vitormosousa/Wireless-anemometer/hardware_esp8266-anemometer/noname.kicad_pcb

## KiCad design hardware_esp8266-anemometer/noname.kicad_pcb (2019-09-09)

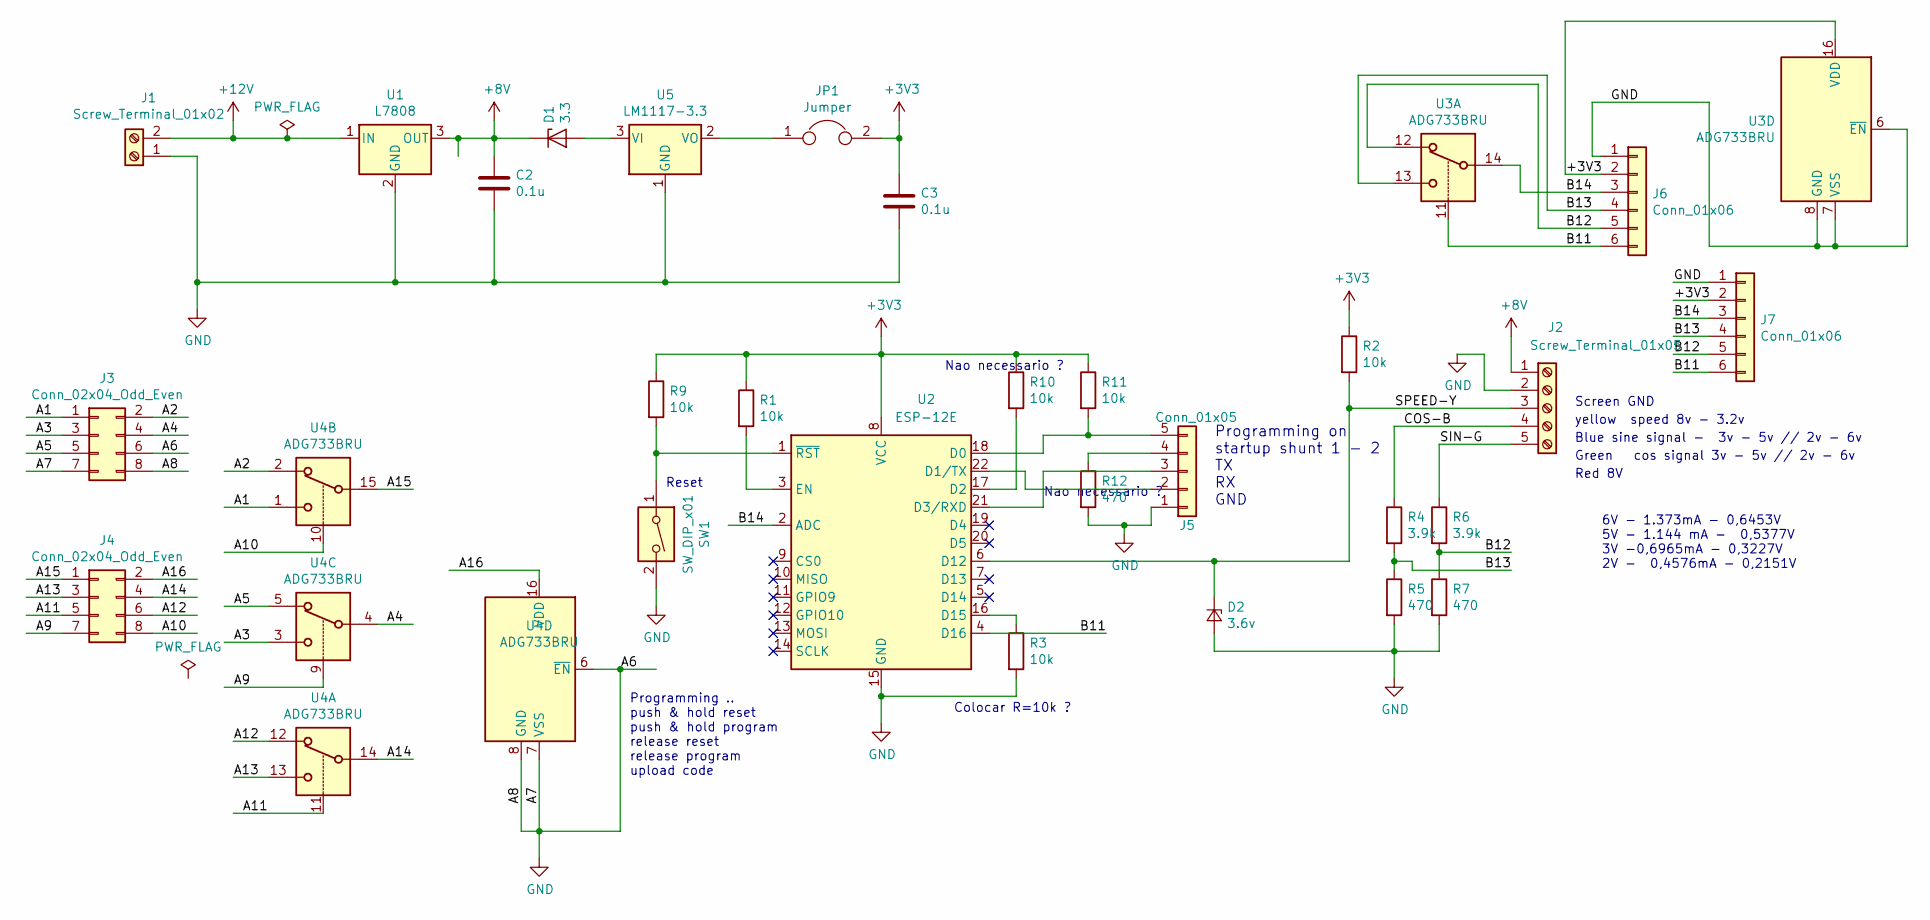
[picture p1: schematic esp8266-anemometer.sch]

Parts:
C2, C3: 0.1u; C_Disc_D4.3mm_W1.9mm_P5.00mm
D1: 3.3; D_DO-15_P10.16mm_Horizontal
D2: 3.6v; D_DO-15_P5.08mm_Vertical_AnodeUp
J1: Screw_Terminal_01x02; TerminalBlock_bornier-2_P5.08mm
J2: Screw_Terminal_01x05; TerminalBlock_bornier-5_P5.08mm
J3, J4: Conn_02x04_Odd_Even; PinHeader_2x04_P2.54mm_Vertical
J5: Conn_01x05; PinHeader_1x05_P2.54mm_Vertical
J6, J7: Conn_01x06; PinHeader_1x06_P2.54mm_Vertical
JP1: Jumper; PinHeader_1x02_P2.54mm_Vertical
R1, R10, R11: 10k; R_Axial_DIN0207_L6.3mm_D2.5mm_P10.16mm_Horizontal
R2, R3: 10k; R_Axial_DIN0204_L3.6mm_D1.6mm_P5.08mm_Vertical
R4, R6: 3.9k; R_Axial_DIN0207_L6.3mm_D2.5mm_P10.16mm_Horizontal
R5, R7, R12: 470; R_Axial_DIN0207_L6.3mm_D2.5mm_P10.16mm_Horizontal
R9: 10k; R_Axial_DIN0207_L6.3mm_D2.5mm_P15.24mm_Horizontal
SW1: SW_DIP_x01; SW_PUSH_6mm
U1: L7808; TO-220-3_Vertical
U2: ESP-12E
U3, U4: ADG733BRU; TSSOP-16_4.4x5mm_P0.65mm
U5: LM1117-3.3; TO-220-3_Vertical

Connections:
+8V: C2.1, D1.1 (K), J2.1, U1.3 (OUT)
+12V: J1.2, U1.1 (IN)
/A1: J3.1, U4.1
/A2: J3.2, U4.2
/A3: J3.3, U4.3
/A4: J3.4, U4.4
/A5: J3.5, U4.5
/A9: J4.7, U4.9
/A10: J4.8, U4.10
/A11: J4.5, U4.11
/A12: J4.6, U4.12
/A13: J4.3, U4.13
/A14: J4.4, U4.14
/A15: J4.1, U4.15
/A16: J4.2, U4.16 (VDD)
/B11: J6.6, J7.6, U2.4 (D16), U3.11
/B12: J6.5, J7.5, R6.2, R7.1, U3.12
/B13: J6.4, J7.4, R4.2, R5.1, U3.13
/B14: J6.3, J7.3, U2.2 (ADC), U3.14
/COS-B: J2.4, R4.1
/SIN-G: J2.5, R6.1
/SPEED-Y: D2.1 (K), J2.3, R2.2, U2.6 (D12)
GND: C2.2, C3.2, D2.2 (A), J1.1, J2.2, J3.6, J3.7, J3.8, J5.1, J6.1, J7.1, R3.2, R5.2, R7.2, R12.2, SW1.2, U1.2 (GND), U2.15 (GND), U3.6 (~EN), U3.7 (VSS), U3.8 (GND), U4.6 (~EN), U4.7 (VSS), U4.8 (GND), U5.1 (GND)
unnamed: D1.2 (A), U5.3 (VI)
unnamed: J5.2, U2.22 (D1/TX)
unnamed: J5.3, U2.21 (D3/RXD)
unnamed: J5.4, R12.1
unnamed: J5.5, R11.2, U2.18 (D0)
unnamed: JP1.1, U5.2 (VO)
unnamed: R1.2, U2.3 (EN)
unnamed: R3.1, U2.16 (D15)
unnamed: R9.2, SW1.1, U2.1 (~RST)
unnamed: R10.2, U2.17 (D2)

Notes on the sheet:
Red 8V
Screen GND
Blue sine signal - 3v - 5v // 2v - 6v
Green cos signal 3v - 5v // 2v - 6v
yellow speed 8v - 3.2v
Programming on startup shunt 1 - 2 TX RX GND
Programming .. push & hold reset push & hold program release reset release program upload code
Reset
Colocar R=10k ?
Nao necessario ?
6V - 1.373mA - 0,6453V 5V - 1.144 mA - 0,5377V 3V -0,6965mA - 0,3227V 2V - 0,4576mA - 0,2151V

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
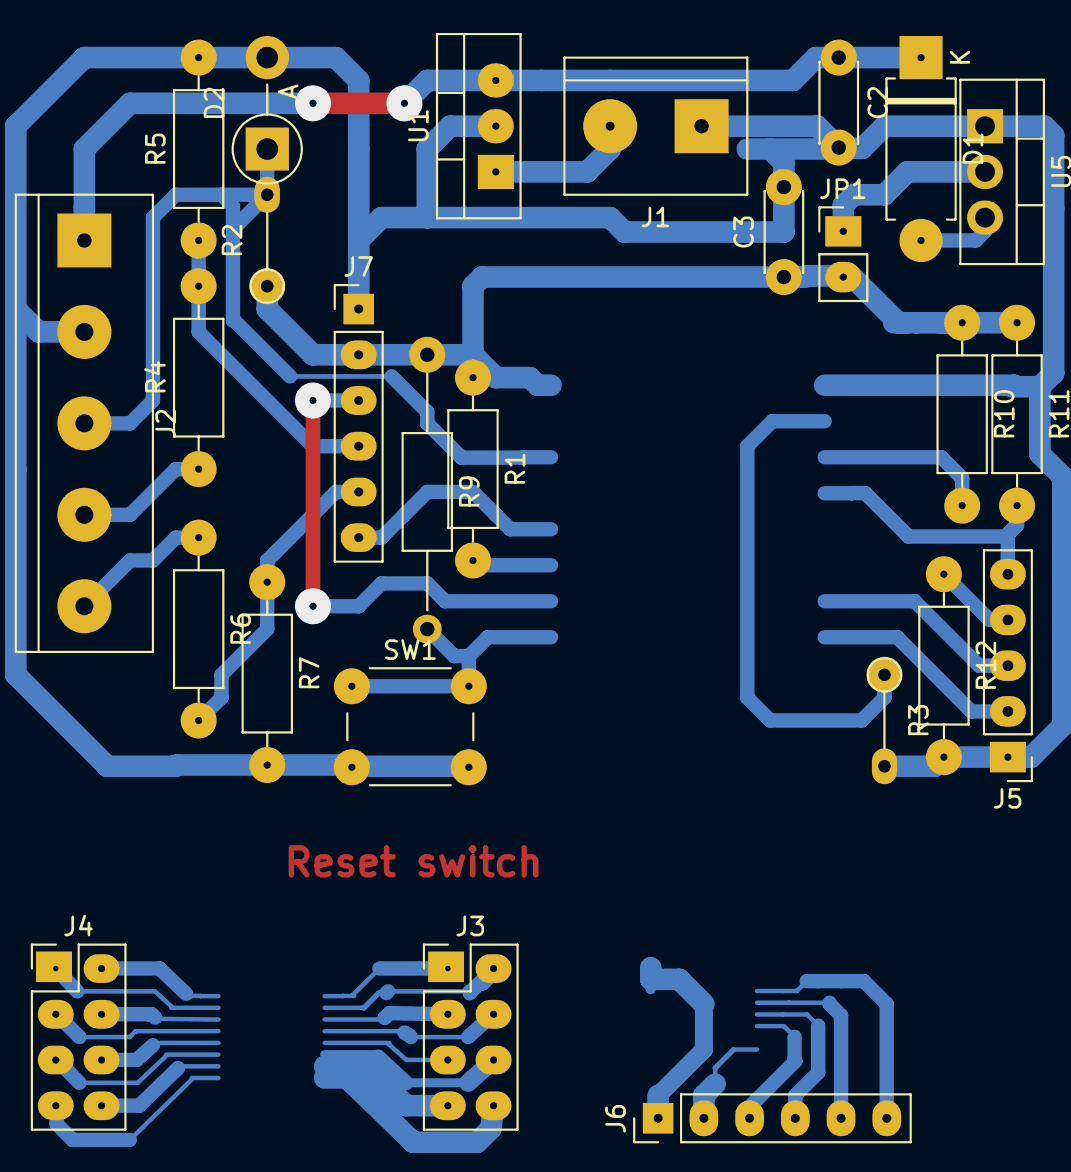
[picture p2: board noname.kicad_pcb from above]

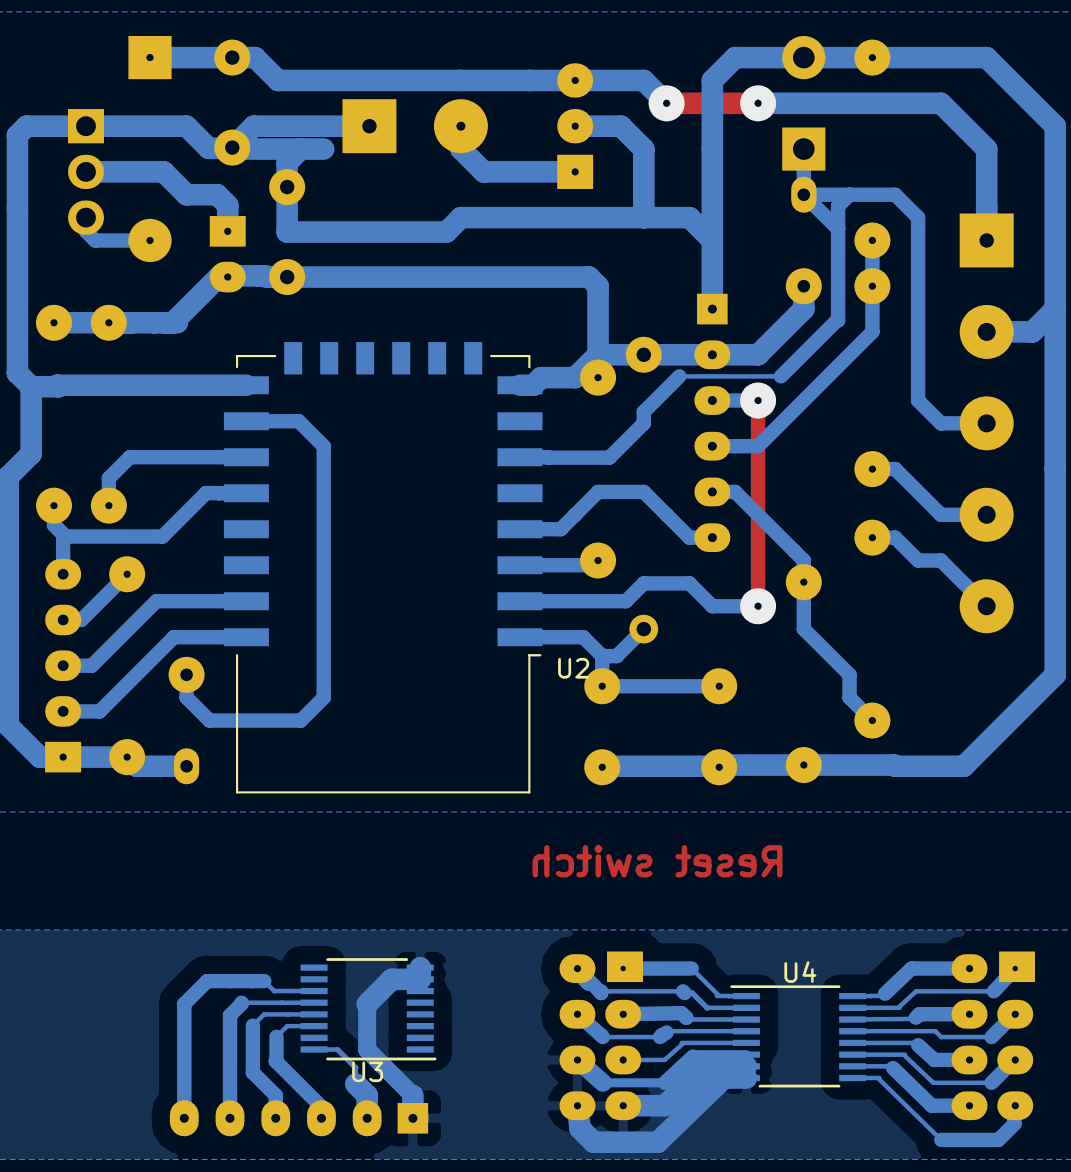
[picture p3: board noname.kicad_pcb from below]

Board: 2 copper layers, 29 parts (3 on the bottom side), 35 nets.
